HandHeldLegend/SuperGamepadPlus/README.md

# Super Gamepad+
This is the official Github page for the Super Gamepad+ from Retro Playground.
Retro Playground is a collaborative effort between Hand Held Legend and RetroSix.

## Software and PCB License
<br />This firmware and PCB model are licensed under a <a rel="license" href="http://creativecommons.org/licenses/by-nc-sa/3.0/">Creative Commons Attribution-NonCommercial-ShareAlike 3.0 Unported License</a>.
