HandHeldLegend/SuperGamepadPlus/SuperGamepadPlus Battery Clip.step

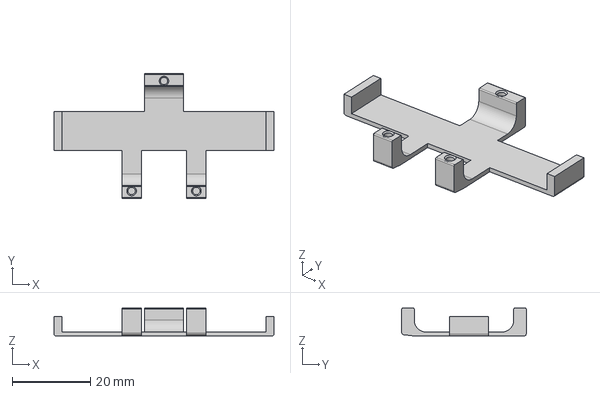
[picture p1: CAD file, 2024-04-03]
SuperGamepadPlus Battery Clip.step
56.1 x 31.7 x 7.10 mm
