HandHeldLegend/SuperGamepadPlus/PCB/main_pcb/sgpp_main_pcb.pdf

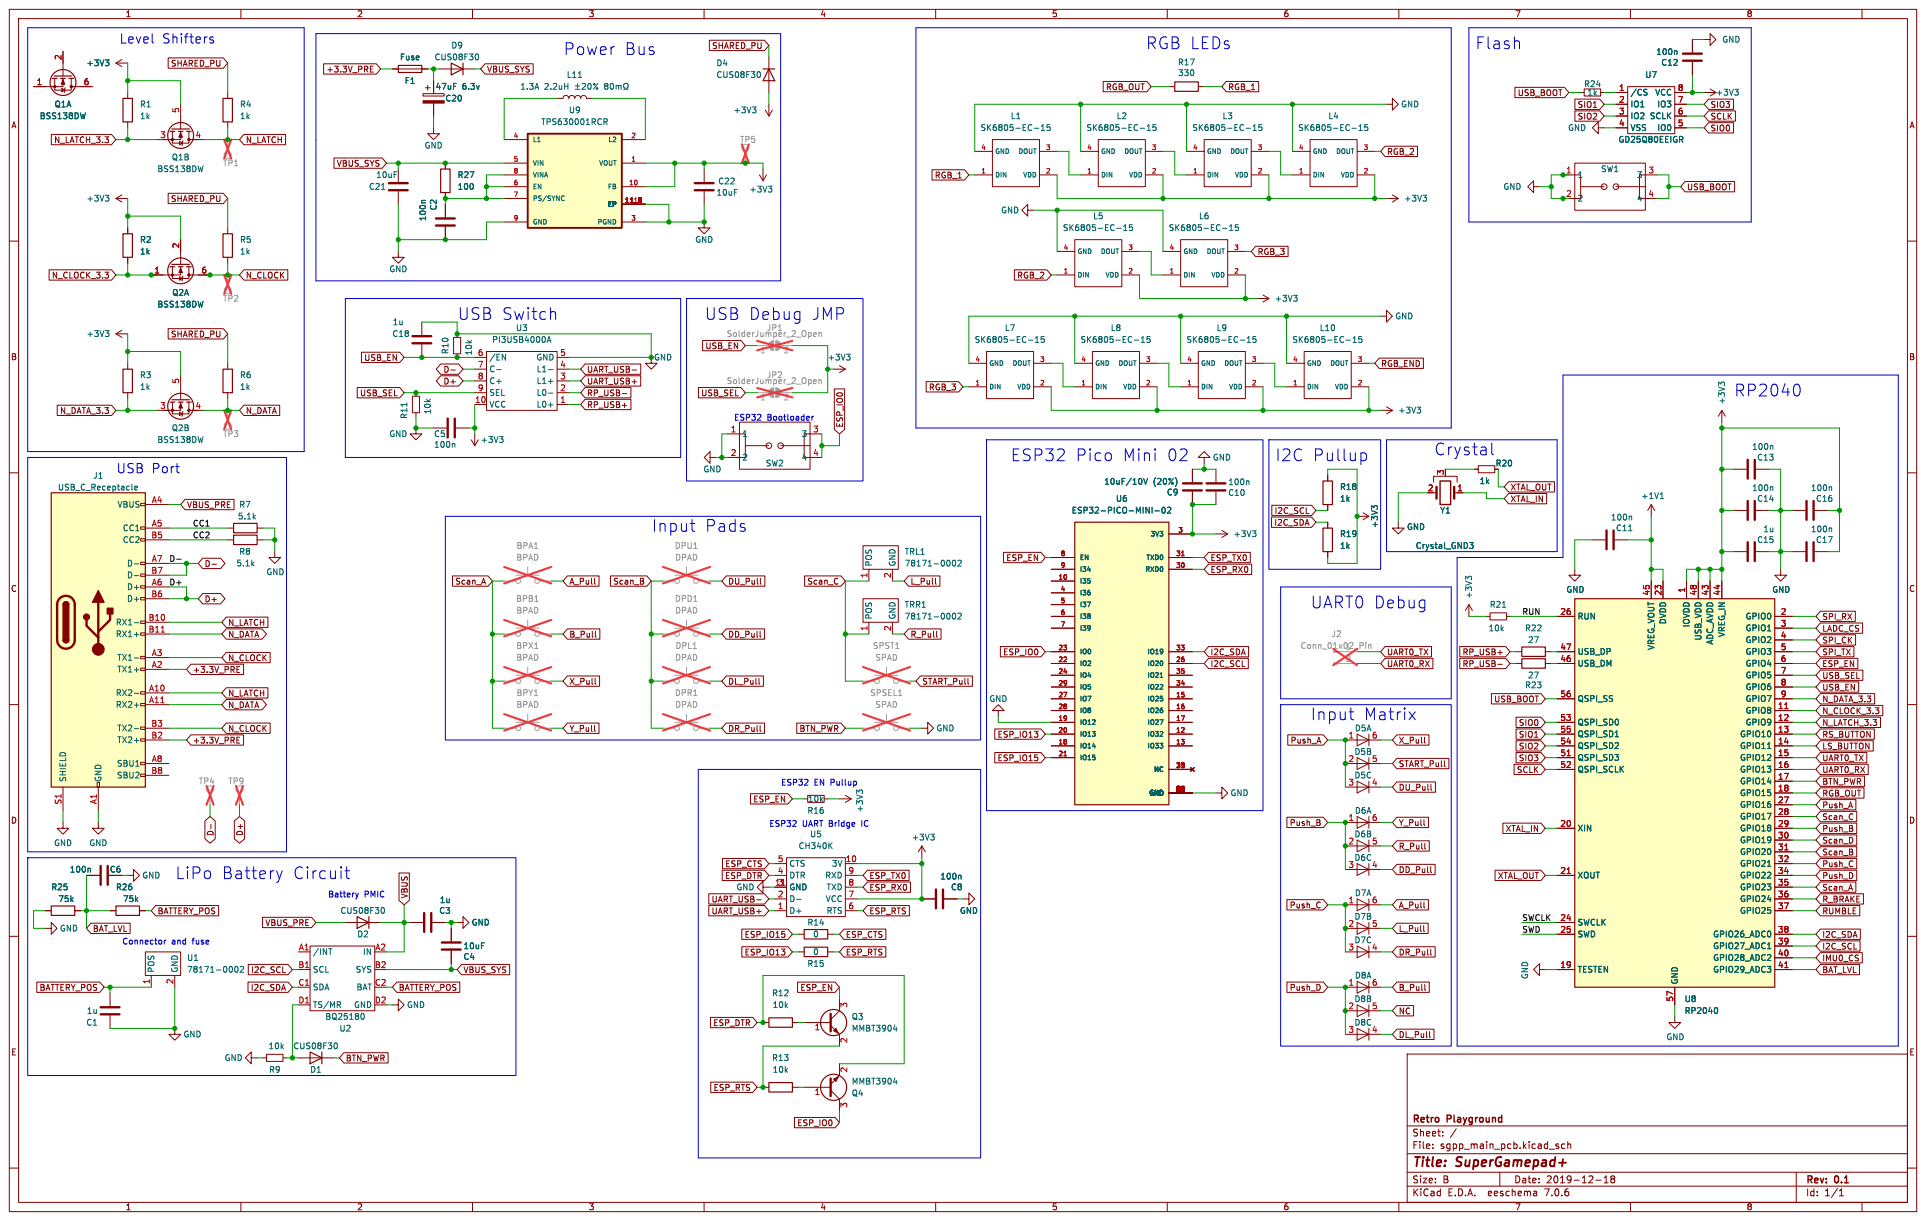
[picture p2: page 1]
