HandHeldLegend/SuperGamepadPlus/(commit log)

2023-09-02 Add batt divider
    [SuperGamepad+_BOM.xlsx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]
2023-09-07 Change regulator
    [SuperGamepad+_BOM.xlsx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]
2023-10-18 ESP32 update and more
    - ESP32 bt core update
    - Update PCB to fix issues
    [sgpp_main_pcb.kicad_sch]
2023-11-03 Split out ESP32 firmware
2023-12-20 PCB Update
    - Update regulator
    [sgpp_main_pcb.kicad_pcb, sgpp_main_pcb.kicad_sch]
2023-12-28 PCB Updates
    [Super Gamepad+ PCB Notes.xlsx, SuperGamepad+_BOM.xlsx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]
2024-04-03 FW Update and LIb update
    [SuperGamepadPlus Battery Clip.step]
2024-06-13 Update to disable charge SNES mode
2024-06-24 Charging update
    Add breathing animation for charging
2025-02-02 FW Move
    FW Moved to https://github.com/HandHeldLegend/hoja-device-fw/tree/main/boards
2025-02-05 SGPP 2 Prep
    [sgpp_2_pcb.kicad_pcb, sgpp_2_pcb.kicad_sch, sgpp_main_pcb.csv, sgpp_main_pcb.kicad_pcb, sgpp_main_pcb.kicad_sch, sgpp_main_pcb.sch]
